KaitlynOoi/eat-me-first/README.md

# 🥕 Eat Me First

A sensor pod for your fridge, freezer or pantry, plus a phone web app. It tracks your food, warns you before it goes off, and suggests recipes that use the soonest-expiring items.

**Everything is free by default.** No hardware yet? A built-in fake pod sends readings so the whole app works today.

| Part | How | Cost |
|---|---|---|
| Data storage | `data.json` on your laptop (Firebase free tier optional) | Free |
| Recipes | [TheMealDB](https://www.themealdb.com) public API | Free, no key |
| Phone alerts | [ntfy.sh](https://ntfy.sh) | Free, no account |
| Adding food | Barcode scan ([Open Food Facts](https://world.openfoodfacts.org)), quick-add, type anything | Free |
| Fresh produce photos | TensorFlow.js + MobileNet, on the phone | Free |
| AI photo scan (optional) | Claude Haiku | Under 1 cent per photo |

## Features
- **Fridge tab:**
  - A weekly score: eaten vs tossed, % saved, ≈ $ saved, and which food you waste most.
  - A **Cook these today** card with a recipe for each item expiring within 2 days.
  - Food grouped into Eat today, Eat soon and Fresh.
  - Tap an item to edit its days left: Opened it, +1 day, Use today, or Remove if you added it by mistake.
- **✓ Ate it / Tossed:** each one counts toward your score, every action has **Undo**, and **Recently removed** has a Restore button for anything you got wrong.
- **Add tab:**
  - **Barcode scan** (free): point the phone camera at a pack, and the product name plus estimated shelf life come from Open Food Facts. Decoding runs on the phone with [zxing-cpp](https://github.com/zxing-cpp/zxing-cpp) (or the phone's built-in reader on Android). If the camera doesn't work, use a photo of the barcode or type the number.
  - **Type any food:** we estimate how long it lasts from the name (e.g. "chicken thighs" → 2 days) and you can change it.
  - **Quick add:** about 45 everyday US groceries, grouped by Meat & Seafood, Dairy & Eggs, Produce, Bakery and Leftovers. Use these for butcher, deli and loose produce that have no barcode.
  - **Snap fresh produce** (free, on-phone AI): take a photo of one fruit or vegetable. MobileNet v2 (TensorFlow.js, self-hosted, ~15 MB, downloaded on first use) shows its top guesses with confidence. You confirm or pick the right one before anything is added. It recognizes about 35 foods (banana, apple, orange, lemon, strawberry, pineapple, broccoli, cauliflower, cucumber, zucchini, bell pepper, corn, pizza…). Tomatoes, carrots, onions, potatoes and meat aren't in the model, so pick those from the list.
  - **Store price stickers** (meat/deli/produce scale labels) are recognized when scanned, and you pick what it is.
  - AI photo scan appears only when an Anthropic key is set.
- **Recipes tab:** **search** any dish, ingredient, category or cuisine ("pasta", "mexican", "dessert"). Results and recommendations are ranked by how much of your soon-to-expire fridge food they use. Chips show what you have and what you'd need to buy, and **🛒 Add to list** sends the missing items to your shopping list.
- **List tab:** a shopping list. Tap to tick items off, then clear the checked ones.

## Run it

You need [Node.js 18+](https://nodejs.org).

```bash
npm install
cp .env.example .env
npm start
```

Open http://localhost:3000. To use it on your phone, connect to the same WiFi and open the "your phone" address that the server prints.

## Put it online for anyone (free, Render)
1. **Set up Firebase first** (see below). Free Render servers restart often and wipe local files, so without Firebase your food list resets to the demo items.
2. Go to https://render.com and sign up with **GitHub**. Allow Render to access the `eat-me-first` repo.
3. Click **New + → Blueprint** and choose `eat-me-first`. Render reads `render.yaml`.
4. Fill in `FIREBASE_DB_URL`, plus `NTFY_TOPIC` and `ANTHROPIC_API_KEY` if you use them, then click **Apply**.
5. After about 2 minutes you get a public link like `https://eat-me-first.onrender.com`.

Every `git push` redeploys the app automatically.

Free plan notes:
- The app sleeps after 15 minutes with no visitors, and the first visit after that takes about 30 seconds to load. Open it a minute before you present.
- While it's asleep, the alert checks stop too. A free ping service such as UptimeRobot can load `/api/state` every 10 minutes to keep it awake.
- Anyone with the link can see and change the food list.

## Turn on phone alerts (2 minutes)
1. Install the **ntfy** app (iOS/Android).
2. Choose an unguessable topic name, e.g. `eatmefirst-k7x92q`. Subscribe to it in the app.
3. Put it in `.env` as `NTFY_TOPIC=eatmefirst-k7x92q` and restart.
4. In the app, open **Fridge → Demo controls → Send test phone alert**.

## Turn on photo scan (optional)
Get an API key at https://console.anthropic.com, then put `ANTHROPIC_API_KEY=...` in `.env` and restart. Without a key, the photo button is hidden and quick-add still works.

## Use Firebase instead of data.json (optional)
1. Go to https://console.firebase.google.com, add a project, then go to **Build → Realtime Database → Create database** and choose **test mode**.
2. Copy the database URL (e.g. `https://eat-me-first-default-rtdb.firebaseio.com`) into `.env` as `FIREBASE_DB_URL`.
3. Restart the server.

## Demo tips
The Fridge tab has **Demo controls** that make the fake pod act out each scenario:
- **Fridge failing (9°C)** triggers the food-safety alert after `WARM_ALERT_MIN` minutes.
- **Banana ripening** makes gas rise above the baseline and triggers a "something is ripening" alert.
- **Freezer / Pantry** "moves" the pod, so it detects the new environment and items age at a different rate.

For a live demo, shorten the timers in `.env`:
```
AVG_WINDOW_MIN=0.5
WARM_ALERT_MIN=1
```

## How it works
- **Environment:** the average temperature over the last 15 minutes decides where the pod is. Below -10°C is the freezer, 0–5°C is the fridge, and 15–25°C is the pantry. In-between temperatures (like an open door) keep the last known environment.
- **Shelf life:** each item has a base life in each environment, and the item's age adds up as a fraction of that life. Time in a fridge above 7°C counts at pantry speed.
- **Alerts:**
  - Fridge above 7°C for 1+ hour
  - Gas rising for 3+ readings above baseline +25%
  - Any item with under 2 days left. This alert includes a free recipe idea.

## The pod: automatic, or your own settings
- **Real pod connected:** everything is sensed automatically. Location (fridge/freezer/pantry) comes from the 15-minute temperature average, and spoilage speed comes from temperature and gas.
- **No pod:** the app uses your settings (⚙️ → Where is your pod? / Temperature). Enter your fridge temperature if you know it, or leave it empty for a typical one.
- **Demo mode** (⚙️ → Demo): a simulated pod with demo buttons, for presenting without hardware. It never runs while a real pod is connected.

**Spoilage forecast:** each item ages faster or slower than normal. Temperature follows the Q10 rule (about 3× faster per +10°C vs a typical 4°C fridge or 21°C pantry). Ripening gas above the pod's normal level speeds up fruit and veg only (up to 3×). Items show e.g. "⚡ 1 day sooner · warm".

## Connecting the hardware to the app
The pod is an **ESP32** with a temperature/humidity sensor, a gas sensor and a **16x2 LCD**. It talks to the app over WiFi:

```
 ESP32 pod ──(every 5 s: temperature, humidity, gas)──▶ app server (Render)
     ▲                                                     │
     └──────(reply: what the LCD should show)─────────────┘
 Your phone ◀──── app (same server): items, forecasts, alerts, the "📟 Pod screen" preview
```

### Wiring: ESP32-S3 + 37-in-1 sensor kit + bare 16x2 LCD
Everything goes on **one side** of the ESP32-S3 DevKit: `3V3, RST, 4, 5, 6, 7, 15, 16, 17, 18, 8, 3, 46, 9, 10, 11, 12, 13, 5V` (GND is at the end of either header). **Don't use GPIO 3 or 46:** the chip reads them at power-up.

| Part | Part pin | → ESP32-S3 |
|---|---|---|
| **Thermistor temperature module** (kit "digital temperature", KY-028: pins AO G + DO) | AO | **GPIO 4** (analog) |
| | G | **GND** |
| | + | **3V3** (not 5V) |
| | DO | *not connected* |
| **RGB LED** module (4 pins) | R | **GPIO 7** |
| | G | **GPIO 15** |
| | B | **GPIO 16** |
| | − | **GND** |
| **16x2 LCD** (bare, 16 pins) | 1 VSS | **GND** |
| | 2 VDD | **5V** |
| | 3 V0 (contrast) | **1kΩ → GND** (2.2kΩ if too dark, or a 10k pot) |
| | 4 RS | **GPIO 17** |
| | 5 RW | **GND** |
| | 6 E | **GPIO 18** |
| | 7–10 D0–D3 | *not connected* |
| | 11 D4 | **GPIO 8** |
| | 12 D5 | **GPIO 9** |
| | 13 D6 | **GPIO 10** |
| | 14 D7 | **GPIO 11** |
| | 15 A (backlight +) | **220Ω → 5V** |
| | 16 K (backlight −) | **GND** |
| *Spare* | | GPIO 5, 6, 12, 13 |

If the RGB module's LED has no small resistors on its board, put a 220Ω resistor in each of the R, G and B wires. The thermistor's conversion is calibrated in the sketch (`THERM_R_FIXED`) for the blue screw's current position, so don't turn the screw. To use a DHT11 or DS18B20 on GPIO 5 instead, set `USE_THERMISTOR 0`.

**Arduino IDE board:** **ESP32S3 Dev Module**, with Partition Scheme **Huge APP**. The pins are chosen automatically for ESP32-S3 vs classic ESP32 (classic ESP32 pins are in the comments at the top of the sketch). For an LCD with an I2C backpack, set `#define LCD_PARALLEL 0`.

### Flash it (new ESP32)
1. In the Arduino IDE, install the board package **esp32 by Espressif**, then these libraries: **DHT sensor library**, **Adafruit Unified Sensor**, **LiquidCrystal** (Arduino), **WiFiManager** (tzapu), and **LiquidCrystal I2C** only if your LCD has a backpack.
2. Open `firmware/eat_me_first_pod/eat_me_first_pod.ino`. `SERVER_URL` is already your Render link. Optionally set `POD_KEY` here **and** in Render → Environment.
3. Tools → Board: **ESP32S3 Dev Module** (classic board: **ESP32 Dev Module**). Tools → Partition Scheme: **Huge APP (3MB No OTA)**, which gives the program room to grow. Pick the port, then Upload. If it says "Connecting...____", hold the **BOOT** button until the upload starts.

Or from a terminal with `arduino-cli`:
```
arduino-cli compile --upload -p /dev/cu.usbserial-XXXX --fqbn esp32:esp32:esp32s3:PartitionScheme=huge_app firmware/eat_me_first_pod
```

### Connect it to WiFi (from your phone, no password in the code)
1. Power the pod. The LCD says **Join WiFi from / EatMeFirst-Setup** and the RGB LED turns purple.
2. On your phone, join the WiFi network **EatMeFirst-Setup**. A setup page opens; if it doesn't, browse to 192.168.4.1.
3. Tap **Configure WiFi**, pick your network (2.4 GHz only, and phone hotspots work), type the password, and Save.
4. The pod remembers it. To switch networks later, hold **BOOT** while pressing **EN/RESET**, and keep holding BOOT for 3 s.

### What you'll see
- **LCD:** "Eat Me First / WiFi connecting" → "WiFi connected", then screens cycling every 3 s: where the pod is and its temperature, **EAT FIRST** + the most urgent item, any alert (the backlight flashes), and the weekly score.
- **App:** the header switches from *no pod* to **pod live**. The pod card shows real readings plus a 📟 preview of the LCD.
- **No WiFi or app down:** the LCD shows the pod's own readings ("App offline" / "No WiFi").
- **RGB LED:** 🟢 green = all good · 🟡 yellow = eat something within 3 days, or a bit warm / ripening gas · 🔴 red = food due today or expired, fridge too warm, or freezer thawing (blinks on a new alert) · 🔵 blue = can't reach WiFi or the app. On power-up it flashes white once.
- The onboard LED blinks once per reading sent, twice if the app had a problem, and three times if there's no WiFi.

```
firmware/   ESP32 sketch (step 1: read sensors)
server/     Node server: storage, alert logic, simulator, recipes, photo scan
public/     The phone web app (plain HTML/CSS/JS)
```
