KaitlynOoi/eat-me-first/(commit log)

2026-10-24 Add free barcode scanning with Open Food Facts lookup
    - Camera scanner (html5-qrcode, vendored) for EAN/UPC; uses the native
    BarcodeDetector on Android and ZXing on iPhone
    - Fallbacks: photo of the barcode, or type the number
    - Server looks up the product and estimates shelf life from its
    category (canned and shelf-stable goods last long everywhere)
    - Unknown products can be named by hand; scanner resumes after each add
    - Hide the AI photo-scan card when no Anthropic key is configured
2026-10-24 Ask for camera access with an explainer, and help when it's blocked
    - Before the phone's prompt, explain why the camera is needed
    - If the camera is denied, show steps for iPhone Safari, Chrome on
    iPhone, Android Chrome or desktop, plus Try again
    - Skip the explainer once permission is granted; handle no-camera and
    non-https cases
2026-10-24 Fix barcode scanning on phones: decode full-resolution camera frames
    The scanner widget shrank each frame to the on-screen box (~320px) before
    decoding, which blurs the 95 bars of a product barcode together, and it
    asked for a low-resolution stream. Replace it with our own camera loop:
    - Request HD video, keep autofocus continuous where supported
    - Decode the middle band at full resolution, alternating with a 2x zoom
    into the centre for small or far barcodes
    - Use the phone's BarcodeDetector when it supports EAN/UPC, otherwise
    zxing-cpp (WebAssembly, self-hosted in /vendor)
    - Aim box overlay, flashlight button where available, distance tip
    - Open Food Facts lookups retry on the server;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
2026-10-24 Free on-phone fresh produce recognition with a confirm step
    - TensorFlow.js + MobileNet v2 (self-hosted, loaded on first use) classifies
    a produce photo on the phone; no API key, no server cost
    - ~45 ImageNet food labels mapped to our foods; whole + centre crops
    - Top 3 guesses with confidence; below 30% says it's not sure
    - Confirm step: pick (or correct, or type) the food, see estimated days,
    then Add to fridge
    - Fix: pass inputRange [0,1] for the TF Hub model (the wrapper assumed
    [-1,1] for custom model URLs, which tanked accuracy)
    - Load photos with onload instead of img.decode(), which can stall in
    background tabs
2026-10-24 Real pod mode, manual settings, spoilage forecast, leaner recipes
    - Pod modes: real pod (auto-sensed), no pod (your location/temperature
    settings), demo (simulated, opt-in, never while a real pod is live)
    - Spoilage model: Q10 temperature factor vs typical fridge/pantry temps,
    thawing-freezer handling, ripening gas speeds up produce only; items
    show how much sooner they'll spoil and why
    - Settings sheet: location auto/manual (+ mismatch warning), optional
    temperature, gas baseline reset, phone alerts, demo mode
    - Firmware step 2: ESP32 posts readings over WiFi (HTTPS) every 5 s,
    gas held back during MQ-3 warm-up, LED send status; optional POD_KEY
    - Pod reading endpoint validates va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
    [eat_me_first_pod.ino]
2026-10-24 ESP32 pod with 16x2 LCD showing what the app knows
    - Server composes LCD screens (place + temp, eat first, then, alert,
    weekly score): ASCII-only, 16 chars, right-aligned values
    - POST /api/pod/reading?lcd=1 replies with the screen text so the ESP32
    needs no JSON library; GET /api/pod/screen.txt for testing
    - Firmware: auto-detects the I2C LCD (0x27/0x3F), cycles screens every
    3 s, flashes the backlight on alerts, shows its own readings when the
    app or WiFi is down (compiles for ESP32 Dev Module)
    - App: live 'Pod screen' preview in the pod card
    - README: wiring table and step-by-step hardware connection guide
2026-10-24 RGB status LED on the pod; LCD finds any I2C backpack address
    - Server sends an urgency level with the LCD text (first line
    'RED|YELLOW|GREEN ALERT|OK'): red = due today/expired, fridge warm
    alert or freezer thawing; yellow = due within 3 days or conditions off
    - Firmware drives a common-cathode (or anode) RGB LED on GPIO 25/26/27:
    green/yellow/red, red blinks on a fresh alert, blue when offline
    - LCD scan covers 0x20-0x27 and 0x38-0x3F
    - App shows the LED colour next to the pod screen preview
2026-10-24 Phone-based WiFi setup for new pods; always serve the newest app
    - Firmware: WiFiManager hotspot 'EatMeFirst-Setup' instead of hardcoded
    credentials; hold BOOT at start-up to forget WiFi; quiet reconnects;
    purple LED while waiting for setup (compiles; Huge APP partition)
    - Server: index.html served with ?v=<deploy> on scripts/styles and
    no-cache, so phones and home-screen apps don't run an old version
    - README: flashing a new ESP32 and WiFi setup steps
2026-10-24 Move LCD (GPIO 32/33) and DHT22 (GPIO 14) to the 3V3 side of the DevKit
    All parts now wire to one side of the board; GPIO 12 avoided (boot
    strapping pin). Firmware compiles; README wiring table updated.
    [eat_me_first_pod.ino]
2026-10-24 ESP32-S3 + bare 16x2 LCD + 37-in-1 kit (DHT11, RGB module) wiring
    - Pins auto-selected for ESP32-S3 (one header side, skipping strapping
    GPIO 3/46) vs classic ESP32
    - Bare HD44780 LCD in 4-bit mode (LCD_PARALLEL 1) or I2C backpack (0)
    - DHT11 by default; RGB kept on S3; single status LED fallback on a
    classic ESP32 with a bare LCD
    - Compiles for ESP32-S3 and ESP32 in both LCD modes; README wiring table
    [eat_me_first_pod.ino]
2026-10-24 Remove the gas sensor from the pod
    Firmware no longer reads or sends gas (temperature + humidity only);
    app hides the gas box and gas settings when the pod has no gas sensor;
    README wiring table updated. Compiles for ESP32-S3.
    [eat_me_first_pod.ino]
2026-10-24 Fix ESP32-S3 boot freeze; accept pod readings when a sensor fails
    - Firmware: include Arduino.h before the board check, so ESP32-S3 builds
    get S3 pins (they were getting classic-ESP32 GPIO 32/33, which are the
    S3's internal flash/PSRAM lines, freezing it at start-up); boot
    checkpoints and reset reason on serial
    - Server: a reading with no sensor values still marks the pod online
    - App: warns when the pod is connected but its temperature sensor
    returns nothing
    [eat_me_first_pod.ino]
2026-10-24 LCD shows only what to eat
    Pod screens are now just EAT FIRST / NEXT / NEXT (the 3 most urgent
    foods); temperature, alerts and the weekly score stay in the app and
    the LED keeps showing urgency. Offline the LCD only says why (No WiFi /
    App offline).
2026-10-24 LCD: one steady screen with the food to eat first; no flicker
    - Server sends a single EAT FIRST screen (most urgent food)
    - Firmware writes padded lines in place instead of clear(), skips
    redraws when nothing changed, and re-initialises the bare LCD every
    minute to recover from glitches
    [eat_me_first_pod.ino]
2026-10-24 LCD: re-sync on every change and after WiFi starts
    A bare HD44780 can drop out of 4-bit sync when the WiFi radio's power
    spike hits; re-initialise before writing new text, right after WiFi
    connects, and every 30 s.
2026-10-24 Power the DHT11 from GPIO 5 on ESP32-S3 (or 3V3)
    Lets the sensor's + leg sit next to its data pin; README notes either
    3V3 pin also works.
2026-10-25 Temperature sensor on GPIO 5 with DS18B20/DHT auto-detect
    At start-up the pod looks for a DS18B20 on the data pin and falls back
    to a DHT11/DHT22; it re-detects after ~30 s of failed reads, so a
    sensor can be swapped without reflashing. README wiring updated.
    [eat_me_first_pod.ino]
2026-10-25 LCD: drop the 5 s rewrite (more writes meant more glitches)
    Back to writing only when the text changes, plus a 30 s re-sync.
    [eat_me_first_pod.ino]
2026-10-25 Use the manual temperature when the pod's sensor isn't reading
2026-10-25 KY-028 thermistor temperature sensor on GPIO 4
    - Analog AO read as the median of 9 batches (2 ms settle between
    samples for the high-impedance divider), smoothed across readings
    - Beta-equation conversion; fixed resistor (the module's trim pot)
    calibrated to ~22 C room temperature
    - USE_THERMISTOR switch keeps DS18B20/DHT auto-detect on GPIO 5
    - README wiring updated
    [eat_me_first_pod.ino]
2026-10-25 Simpler UI: plain scan buttons, no helper text or decorative emojis
    - Add tab: 'Scan barcode' / 'Scan fresh food' buttons, no explanations
    - Removed grey helper text, decorative emojis (food icons stay), the
    alerts list on the first page, and demo mode from Settings
    - Shorter warnings and scanning prompts
2026-10-25 Accurate expiry dates and temperature calibration
    - Use-by date pickers (edit sheet and barcode result) set days left from
    the date printed on the pack; edit sheet shows when the item was added
    and its expected expiry date
    - Pod sends the thermistor's raw voltage; the server converts it with a
    calibratable resistor value, and Settings > Calibrate sensor solves it
    from a known temperature (ice water = 0 C) and re-converts stored
    readings so averages are right immediately
    - Shelf life tightened to USDA FoodKeeper ranges for avocados (4 d),
    corn (2 d) and tomatoes (5 d)
    [eat_me_first_pod.ino]
2026-10-25 Faster, steadier temperature; location switches after 3 steady minutes
    - Firmware samples the thermistor every second, takes the median of the
    last 7 samples (ignores WiFi-transmit dips) and smooths lightly:
    untouched spread 0.4 C, follows real changes in ~5-10 s
    - LED no longer blinks (switching it rippled the 3.3 V rail into the
    reading)
    - Server trusts a new place after STEADY_MIN (3) minutes of steady
    readings instead of waiting for the 15-minute average; door-open
    spikes still can't trigger it
    - Demo items still fill an empty list (SEED_DEMO_ITEMS=0 to disable)
    [eat_me_first_pod.ino]
